ChrisHeiden/Doc_Tangible_Interaction/original_Images/Wirewiring_Soldering/20200127_101702_HDR.jpg

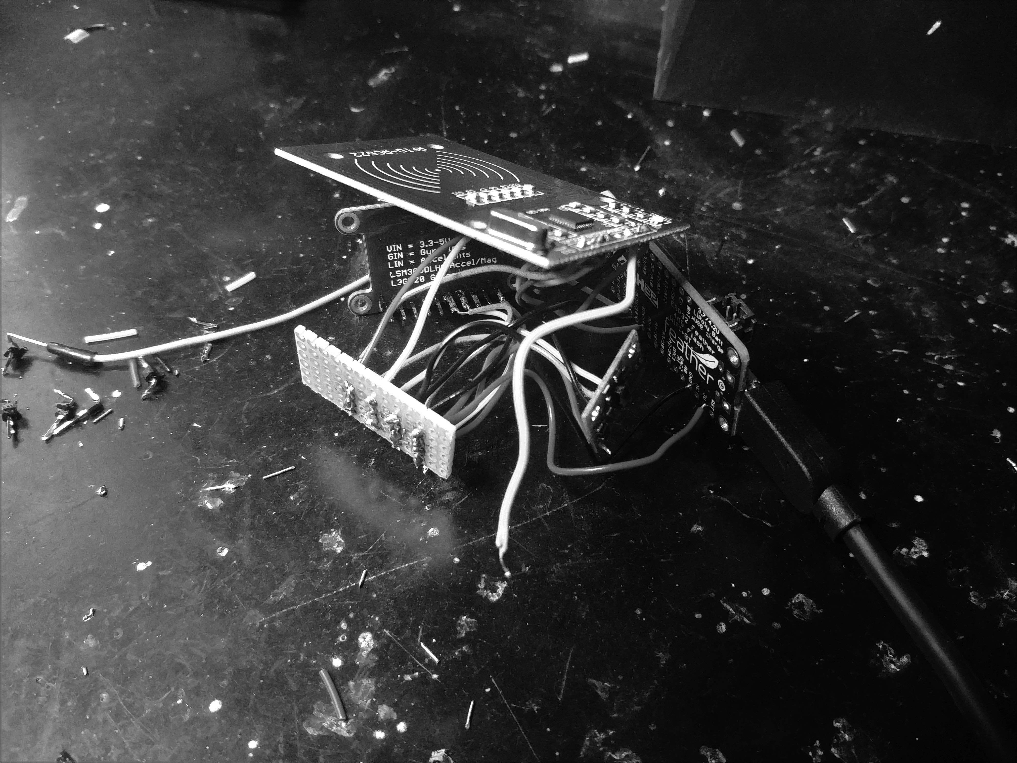
original_Images/Wirewiring_Soldering/20200127_101702_HDR.jpg
