ChrisHeiden/Doc_Tangible_Interaction/original_Images/Wirewiring_Soldering/20200202_091456_HDR.jpg

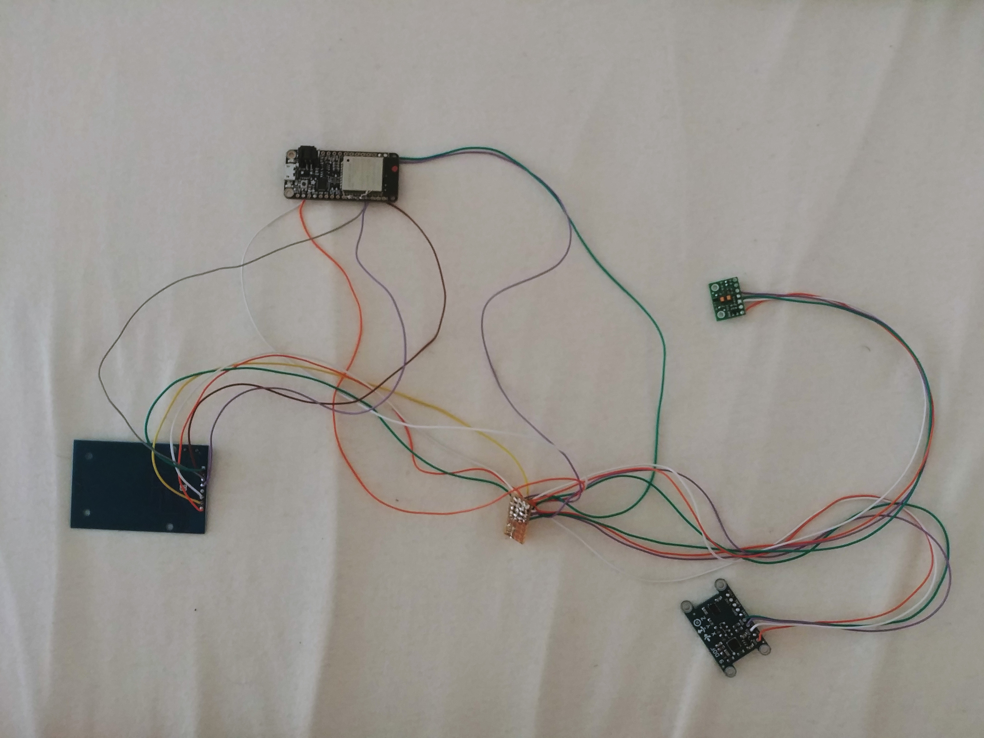
original_Images/Wirewiring_Soldering/20200202_091456_HDR.jpg
