ChrisHeiden/Doc_Tangible_Interaction/original_Images/Wirewiring_Soldering/20200221_164534_HDR.jpg

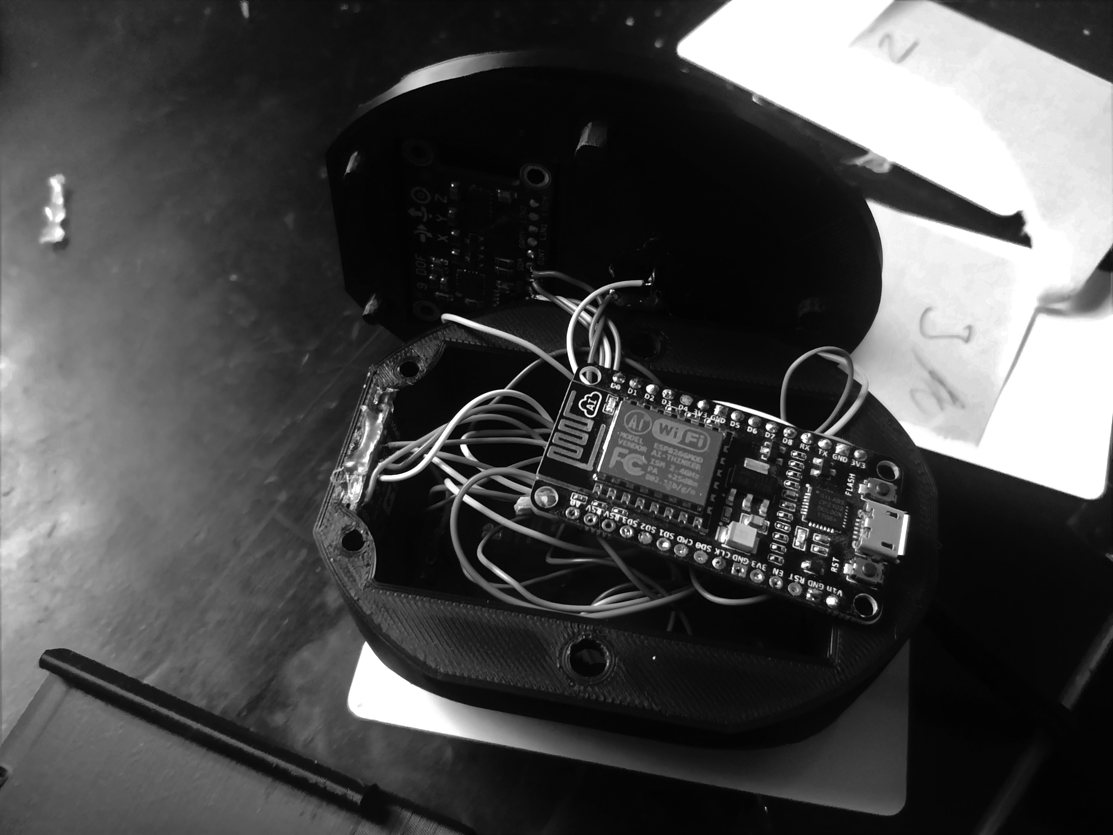
original_Images/Wirewiring_Soldering/20200221_164534_HDR.jpg
