ChrisHeiden/Doc_Tangible_Interaction/original_Images/Wirewiring_Soldering/Sketches/Tangible_Interfaces_Project_1.png

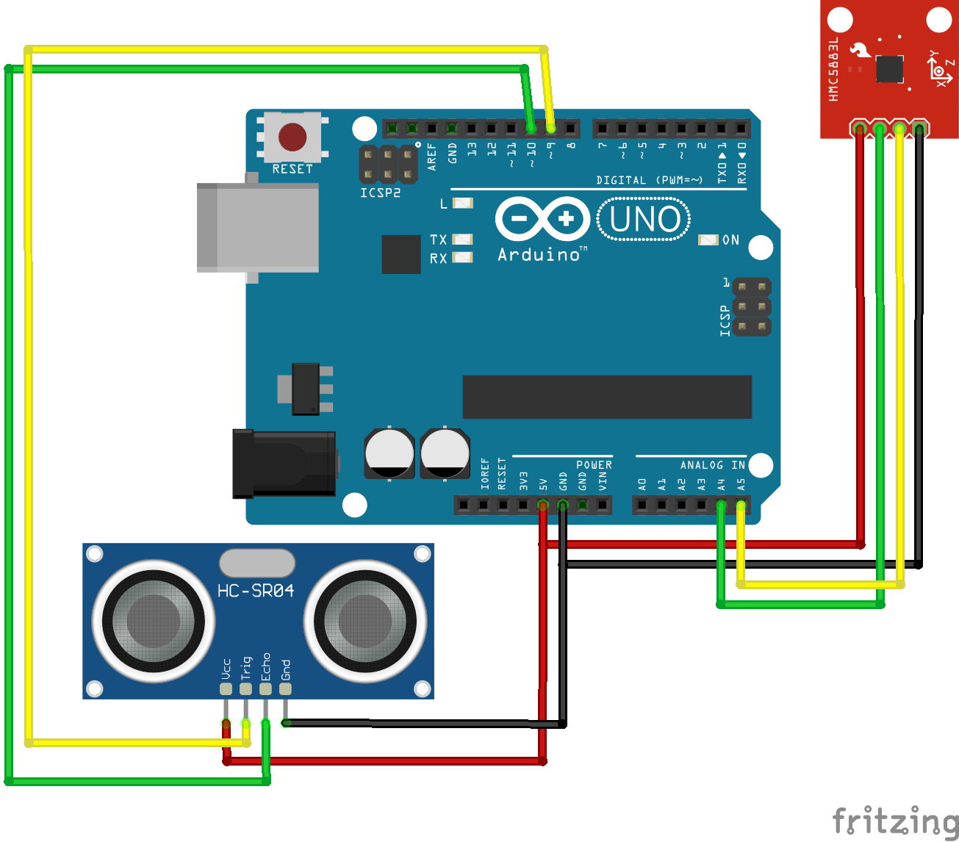
original_Images/Wirewiring_Soldering/Sketches/Tangible_Interfaces_Project_1.png
